MarkusWandel/battery-tester/(commit log)

2021-03-01 Remove README.md in the schematic directory
2021-03-11 Display version string (v1.01) Recheck battery reverse voltage right before activating discharge relays
    [battery-tester.ino]
